cmu-argus-1/Ops-Groundstation/Radio HAT/Board STEP File/Radio HAT.step

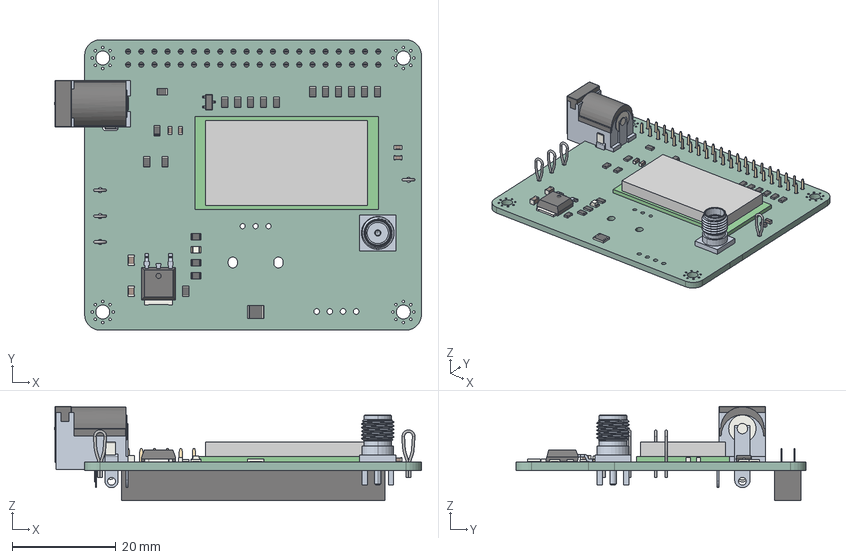
[picture p1: CAD file, 2024-05-26]
Radio HAT/Board STEP File/Radio HAT.step
70.8 x 56.0 x 18.2 mm
R_0805_2012Metric x 19
R_1210_3225Metric
SOT_23
TestPoint_Loop_D2.50mm_Drill1.0mm x 4
C_0805_2012Metric x 2
C_0603_1608Metric x 4
132134_SW0001
PinSocket_2x20_P254mm_Vertical
CQ assembly
RFM98PW v2
BarrelJack_Horizontal
CUI_DEVICES_PJ-002A
LED_0805_2012Metric
Radio HAT_PCB
