cmu-argus-1/Ops-Groundstation/Radio HAT/Radio HAT.kicad_pcb

## KiCad design Radio HAT/Radio HAT.kicad_pcb (2024-09-25)

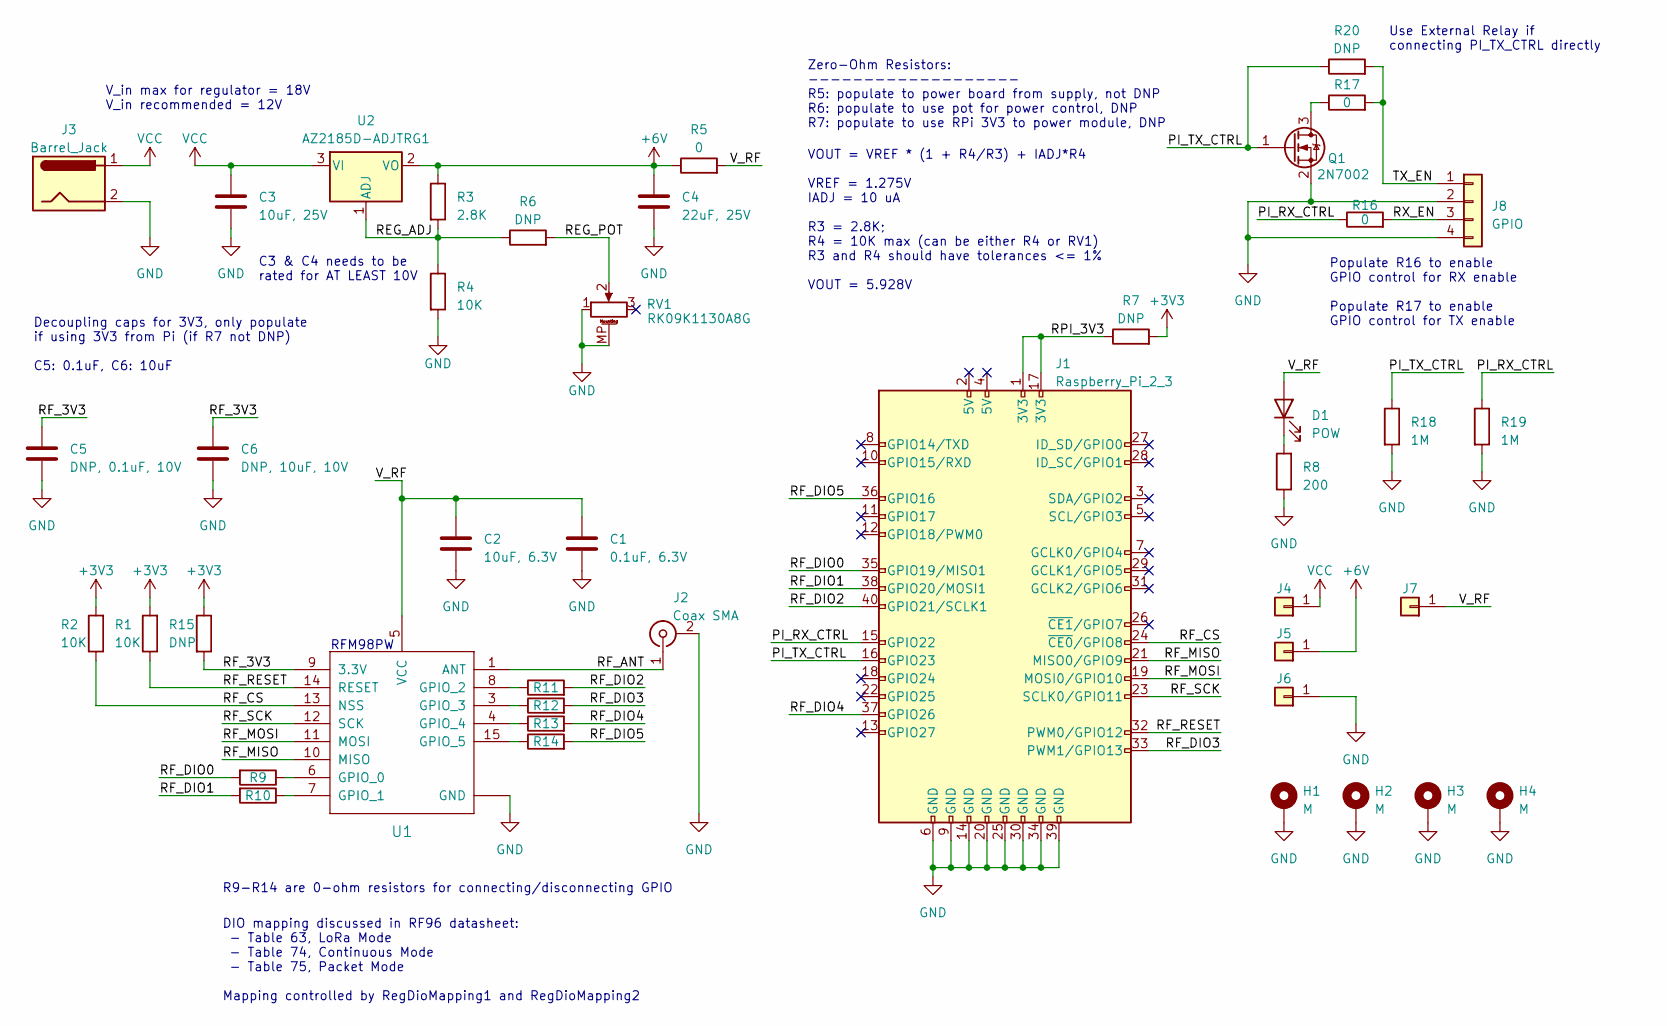
[picture p2: schematic Radio HAT.kicad_sch, Argus-1 Ground Station]

Parts:
C1: 0.1uF, 6.3V; C_0603_1608Metric_Pad1.08x0.95mm_HandSolder
C2: 10uF, 6.3V; C_0603_1608Metric_Pad1.08x0.95mm_HandSolder
C3: 10uF, 25V; C_0805_2012Metric_Pad1.18x1.45mm_HandSolder
C4: 22uF, 25V; C_0805_2012Metric_Pad1.18x1.45mm_HandSolder
C5: DNP, 0.1uF, 10V; C_0603_1608Metric_Pad1.08x0.95mm_HandSolder
C6: DNP, 10uF, 10V; C_0603_1608Metric_Pad1.08x0.95mm_HandSolder
D1: POW; LED_0805_2012Metric_Pad1.15x1.40mm_HandSolder
H1, H2, H3, H4: M; MountingHole_2.7mm_M2.5_Pad_Via
J1: Raspberry_Pi_2_3; PinSocket_2x20_P2.54mm_Vertical
J2: Coax SMA; SMA_Amphenol_901-144_Vertical
J3: Barrel_Jack; BarrelJack_Horizontal
J4: VCC; TestPoint_Loop_D2.50mm_Drill1.0mm
J5: 6V; TestPoint_Loop_D2.50mm_Drill1.0mm
J6: GND; TestPoint_Loop_D2.50mm_Drill1.0mm
J7: V_RF; TestPoint_Loop_D2.50mm_Drill1.0mm
J8: GPIO; TerminalBlock_TE_282834-4_1x04_P2.54mm_Horizontal
Q1: 2N7002; SOT-23
R1, R2, R4: 10K; R_0805_2012Metric_Pad1.20x1.40mm_HandSolder
R3: 2.8K; R_0805_2012Metric_Pad1.20x1.40mm_HandSolder
R5: 0; R_1210_3225Metric_Pad1.30x2.65mm_HandSolder
R6, R7, R15, R20: DNP; R_0805_2012Metric_Pad1.20x1.40mm_HandSolder
R8: 200; R_0805_2012Metric_Pad1.20x1.40mm_HandSolder
R9, R10, R11, R12, R13, R14, R16, R17: 0; R_0805_2012Metric_Pad1.20x1.40mm_HandSolder
R18, R19: 1M; R_0805_2012Metric_Pad1.20x1.40mm_HandSolder
RV1: RK09K1130A8G; Potentiometer_Alps_RK09K_Single_Vertical
U1: RFM98PW; RFM95PW
U2: AZ2185D-ADJTRG1; TO-252-2

Connections:
+3V3: R1.2, R2.2, R7.2, R15.1
+6V: C4.1, J5.1, R3.1, R5.1, U2.2 (VO)
/PI_RX_CTRL: J1.15 (GPIO22), R16.1, R19.1
/PI_TX_CTRL: J1.16 (GPIO23), Q1.1 (G), R18.1, R20.1
/REG_ADJ: R3.2, R4.1, R6.1, U2.1 (ADJ)
/REG_POT: R6.2, RV1.2
/RF_3V3: C5.1, C6.1, R15.2, U1.9 (3.3V)
/RF_ANT: J2.1 (In), U1.1 (ANT)
/RF_CS: J1.24 (~CE0/GPIO8), R2.1, U1.13 (NSS)
/RF_DIO0: J1.35 (GPIO19/MISO1), R9.2
/RF_DIO1: J1.38 (GPIO20/MOSI1), R10.2
/RF_DIO2: J1.40 (GPIO21/SCLK1), R11.2
/RF_DIO3: J1.33 (PWM1/GPIO13), R12.2
/RF_DIO4: J1.37 (GPIO26), R13.2
/RF_DIO5: J1.36 (GPIO16), R14.2
/RF_MISO: J1.21 (MISO0/GPIO9), U1.10 (MISO)
/RF_MOSI: J1.19 (MOSI0/GPIO10), U1.11 (MOSI)
/RF_RESET: J1.32 (PWM0/GPIO12), R1.1, U1.14 (RESET)
/RF_SCK: J1.23 (SCLK0/GPIO11), U1.12 (SCK)
/RPI_3V3: J1.1 (3V3), J1.17 (3V3), R7.1
/RX_EN: J8.3, R16.2
/TX_EN: J8.1, R17.2, R20.2
/V_RF: C1.1, C2.1, D1.2 (A), J7.1, R5.2, U1.5 (VCC)
GND: C1.2, C2.2, C3.2, C4.2, C5.2, C6.2, H1.1, H2.1, H3.1, H4.1, J1.6 (GND), J1.9 (GND), J1.14 (GND), J1.20 (GND), J1.25 (GND), J1.30 (GND), J1.34 (GND), J1.39 (GND), J2.2 (Ext), J3.2, J6.1, J8.2, J8.4, Q1.2 (S), R4.2, R8.1, R18.2, R19.2, RV1.1, RV1.MP (MountPin), U1.2 (GND), U1.16 (GND), U1.17 (GND)
unnamed: D1.1 (K), R8.2
unnamed: Q1.3 (D), R17.1
unnamed: R9.1, U1.6 (GPIO_0)
unnamed: R10.1, U1.7 (GPIO_1)
unnamed: R11.1, U1.8 (GPIO_2)
unnamed: R12.1, U1.3 (GPIO_3)
unnamed: R13.1, U1.4 (GPIO_4)
unnamed: R14.1, U1.15 (GPIO_5)
VCC: C3.1, J3.1, J4.1, U2.3 (VI)

Notes on the sheet:
Populate R16 to enable GPIO control for RX enable Populate R17 to enable GPIO control for TX enable
Decoupling caps for 3V3, only populate if using 3V3 from Pi (if R7 not DNP) C5: 0.1uF, C6: 10uF
DIO mapping discussed in RF96 datasheet: - Table 63, LoRa Mode - Table 74, Continuous Mode - Table 75, Packet Mode Mapping controlled by RegDioMapping1 and RegDioMapping2
Zero-Ohm Resistors: ------------------- R5: populate to power board from supply, not DNP R6: populate to use pot for power control, DNP R7: populate to use RPi 3V3 to power module, DNP
V_in max for regulator = 18V V_in recommended = 12V
RFM98PW
R9-R14 are 0-ohm resistors for connecting/disconnecting GPIO
C3 & C4 needs to be rated for AT LEAST 10V
Use External Relay if connecting PI_TX_CTRL directly
VOUT = VREF * (1 + R4/R3) + IADJ*R4 VREF = 1.275V IADJ = 10 uA R3 = 2.8K; R4 = 10K max (can be either R4 or RV1) R3 and R4 should have tolerances <= 1% VOUT = 5.928V

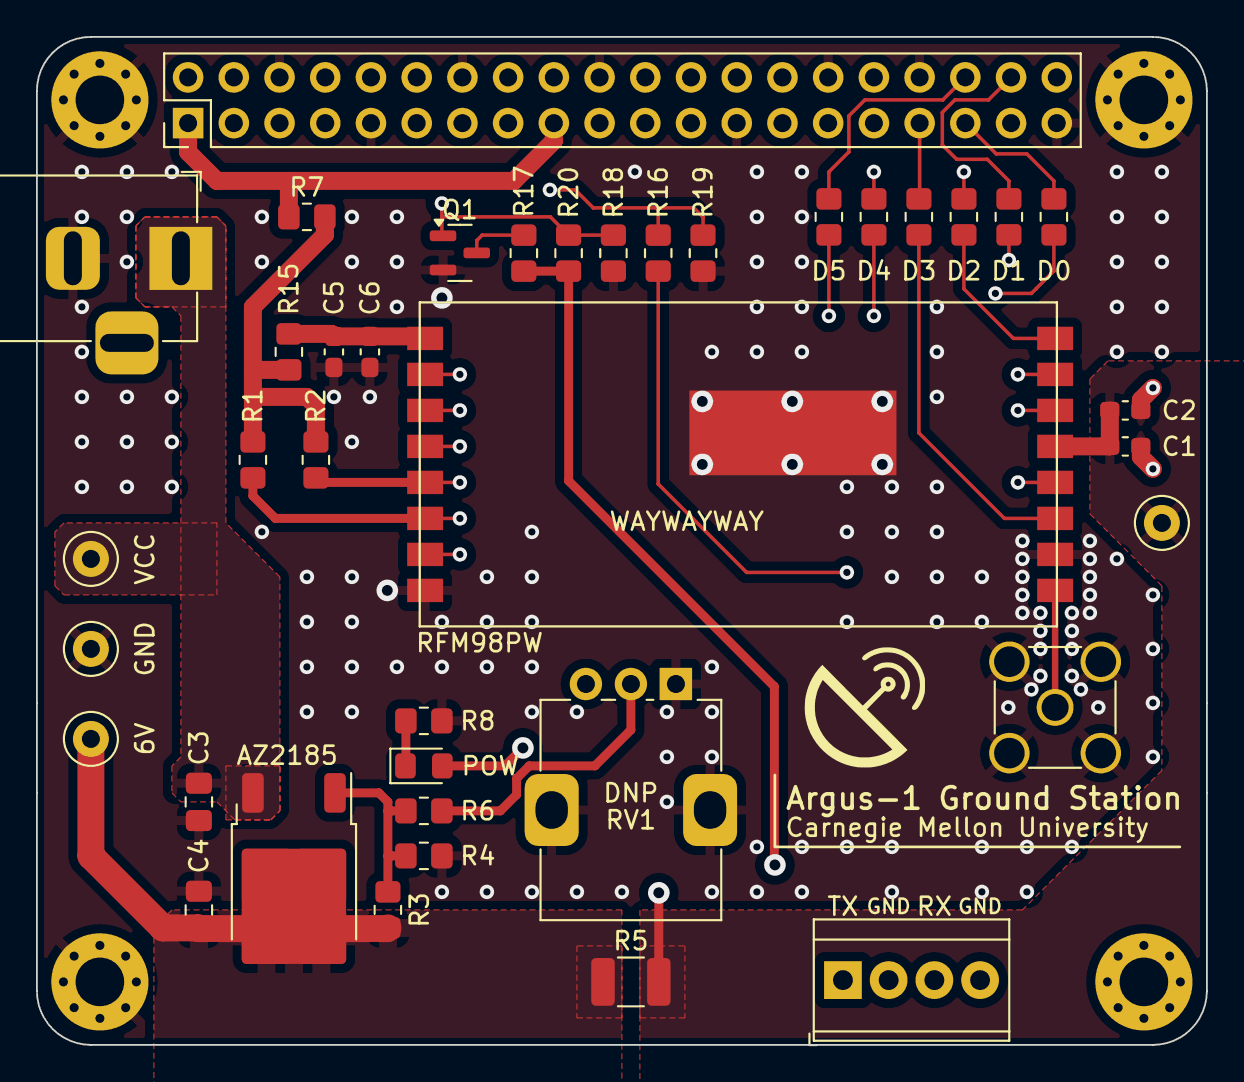
[picture p3: board Radio HAT.kicad_pcb from above]

Board: 4 copper layers, 65.0 x 56.0 mm, 43 parts (0 on the bottom side), 33 nets.
