cmu-argus-1/Ops-Groundstation/(commit log)

2024-04-18 Changes for v1.2
    [Radio HAT-B_Cu.gbl, Radio HAT-B_Mask.gbs, Radio HAT-B_Paste.gbp, Radio HAT-B_Silkscreen.gbo, Radio HAT-Edge_Cuts.gm1, Radio HAT-F_Cu.gtl, Radio HAT-F_Mask.gts, Radio HAT-F_Paste.gtp]
2024-05-02 Fixed TX and RX enable circuits
    [Radio HAT.kicad_pcb, Radio HAT.kicad_sch]
2024-05-05 Added stitching vias
    [Radio HAT.kicad_pcb, Radio HAT.kicad_sch]
2024-05-26 Add bypass resistor on TX GPIO control, ground Pot
    [Radio HAT-B_Cu.gbl, Radio HAT-B_Cu.gbr, Radio HAT-B_Mask.gbr, Radio HAT-B_Paste.gbp, Radio HAT-B_Paste.gbr, Radio HAT-B_Silkscreen.gbo, Radio HAT-B_Silkscreen.gbr, Radio HAT-Edge_Cuts.gbr]
2024-05-26 Export new BOM
2024-09-25 Fixed Q1 footprint
    [Radio HAT.kicad_pcb, Radio HAT.kicad_sch]
