cmu-argus-1/Ops-Groundstation/(notices)

Notices in the files:
Radio HAT/Radio HAT.kicad_sch:
LICENSE: CC BY 4.0
